DetcLab/piBatteryCycler/docs/adafruit_products_MCP4725_sch.png

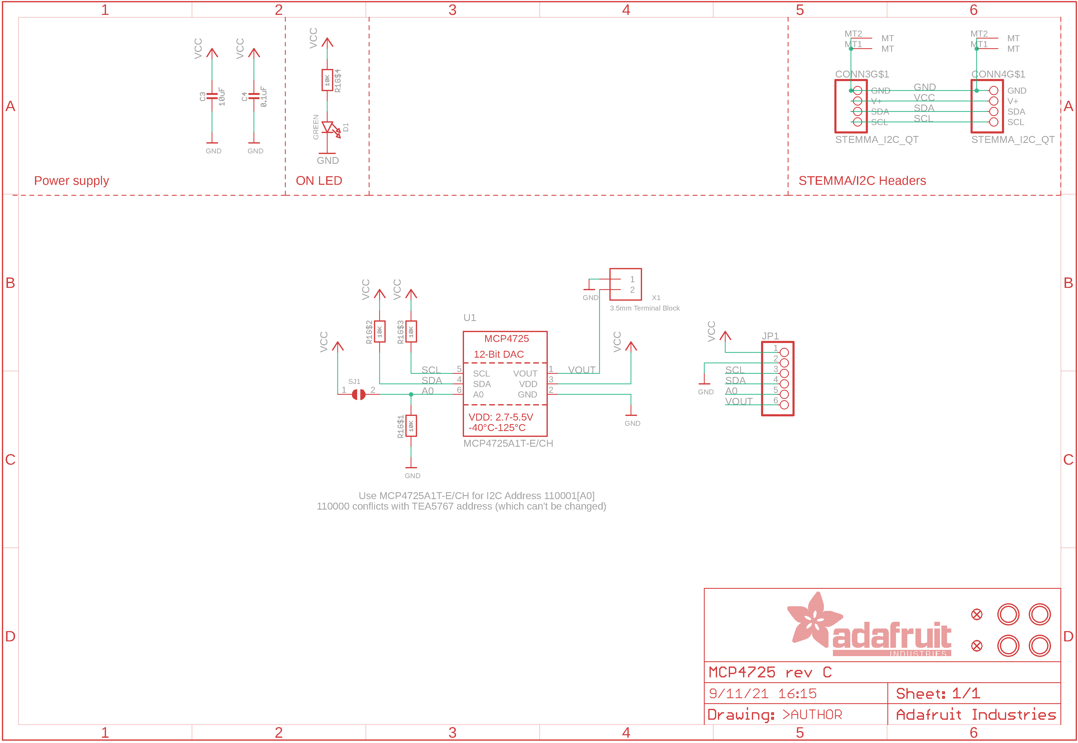
docs/adafruit_products_MCP4725_sch.png
