DetcLab/piBatteryCycler/docs/peligro-alta-temperatura-sin-rotulo.jpg

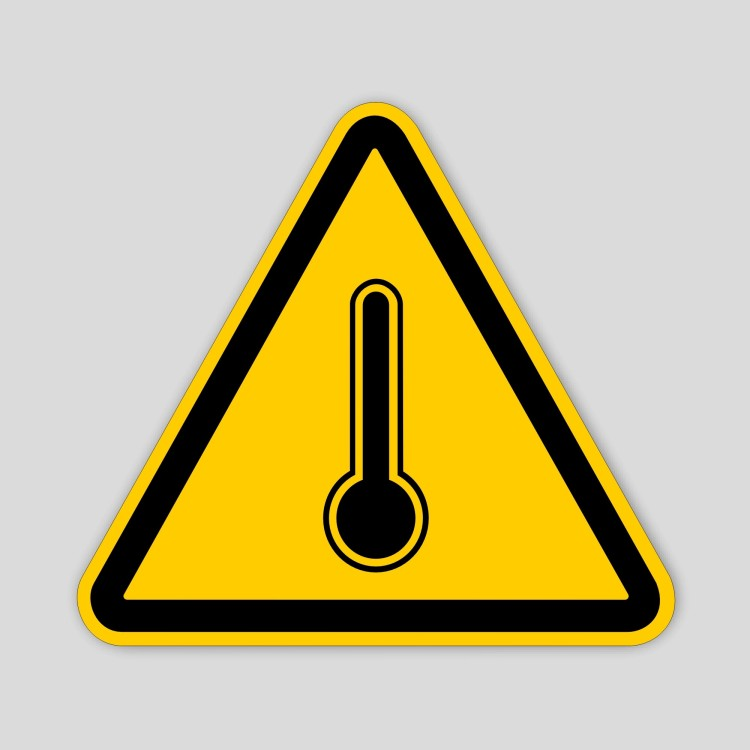
docs/peligro-alta-temperatura-sin-rotulo.jpg
