DetcLab/piBatteryCycler/pcb/V1_bq24_Soc_Externo/pi_battery_cycler.kicad_pcb

## KiCad design pcb/V1_bq24_Soc_Externo/pi_battery_cycler.kicad_pcb (2026-11-11)

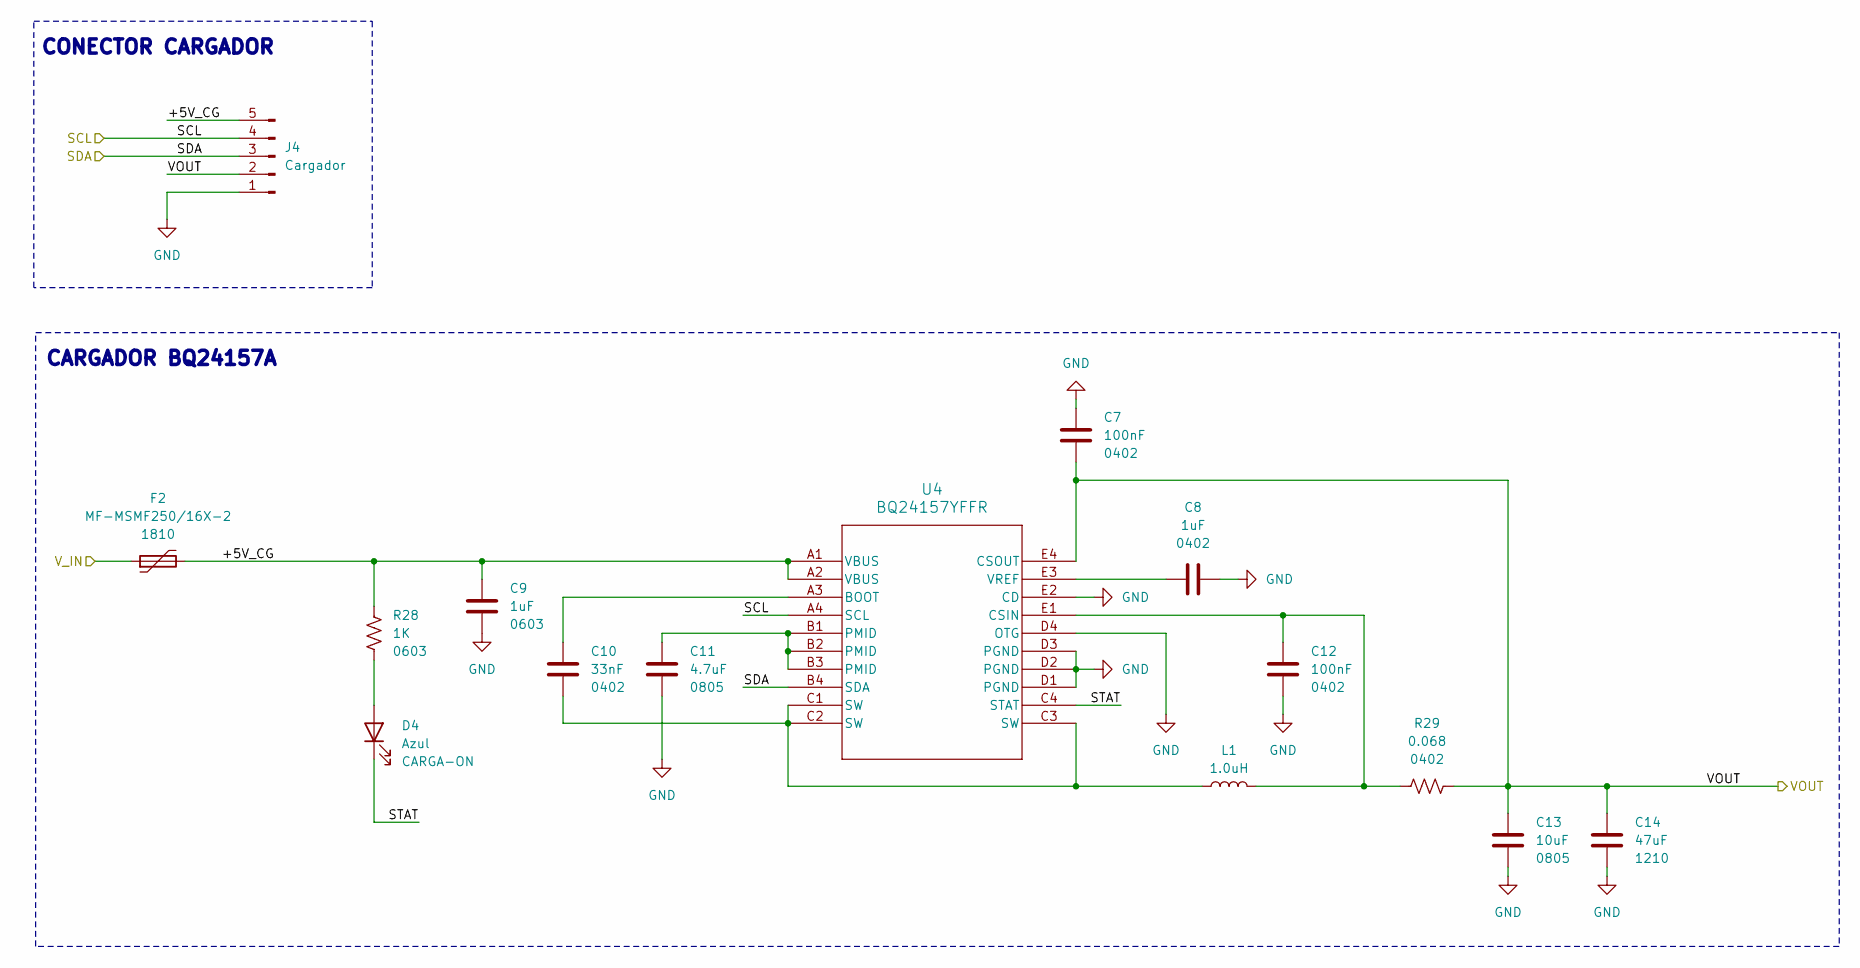
[picture p3: schematic cargador.kicad_sch, PI BATTERY CYCLER]

Parts:
C7, C12: 100nF; C_0402_1005Metric; MPN GRM155R71C104KA88D; Digikey 490-3261-2-ND
C8: 1uF; C_0402_1005Metric; MPN CL05A105KP5NNNC; Digikey 1276-1076-2-ND
C9: 1uF; C_0603_1608Metric_Pad1.08x0.95mm_HandSolder; MPN GRM188R61C105KA12D; Digikey 490-10479-2-ND
C10: 33nF; C_0402_1005Metric; MPN GRM155R61C333KA01D; Digikey 490-5416-2-ND
C11: 4.7uF; C_0805_2012Metric; MPN GRM21BR71C475KE51L; Digikey 490-14466-2-ND
C13: 10uF; C_0805_2012Metric; MPN CL21A106KOQNNNE; Digikey 1276-1096-2-ND
C14: 47uF; C_1210_3225Metric; MPN GRM32ER61A476KE20L; Digikey 490-3887-2-ND
D4: Azul; LED_0603_1608Metric; MPN 150060BS75000; Digikey 732-4966-2-ND
F2: MF-MSMF250/16X-2; Fuse_1812_4532Metric; MPN MF-MSMF250/16X-2; Digikey MF-MSMF250/16X-2TR-ND
J4: Cargador; JST_XH_B5B-XH-A_1x05_P2.50mm_Vertical
L1: 1.0uH; L_1008_2520Metric; MPN LQM2HPN1R0MJ0L; Digikey 490-6699-2-ND
R28: 1K; R_0603_1608Metric_Pad0.98x0.95mm_HandSolder; MPN RC0603FR-071KL; Digikey 311-1.00KHRTR-ND
R29: 0.068; R_0402_1005Metric; MPN ERJ-2BWJR068X; Digikey P.068AMTR-ND
U4: BQ24157YFFR; YFF20_TEX; MPN BQ24157YFFR; Digikey 296-39908-2-ND

Connections:
/CARGADOR/+5V_CG: C9.2, F2.2, J4.5, R28.1, U4.A1 (VBUS), U4.A2 (VBUS)
/CARGADOR/SCL: J4.4, U4.A4 (SCL); also elsewhere on the board
/CARGADOR/SDA: J4.3, U4.B4 (SDA); also elsewhere on the board
/CARGADOR/STAT: D4.1 (K), U4.C4 (STAT)
/CARGADOR/VOUT: C7.1, C13.2, C14.2, J4.2, R29.2, U4.E4 (CSOUT); also elsewhere on the board
/CARGADOR/V_IN: F2.1; also elsewhere on the board
GND: C7.2, C8.2, C9.1, C11.2, C12.1, C13.1, C14.1, J4.1, U4.D1 (PGND), U4.D2 (PGND), U4.D3 (PGND), U4.D4 (OTG), U4.E2 (CD); also elsewhere on the board
unnamed: C10.1, L1.1, U4.C1 (SW), U4.C2 (SW), U4.C3 (SW)
unnamed: C11.1, U4.B1 (PMID), U4.B2 (PMID), U4.B3 (PMID)
unnamed: D4.2 (A), R28.2
unnamed: C10.2, U4.A3 (BOOT)
unnamed: C12.2, L1.2, R29.1, U4.E1 (CSIN)
unnamed: C8.1, U4.E3 (VREF)

Notes on the sheet:
CONECTOR CARGADOR
CARGADOR BQ24157A

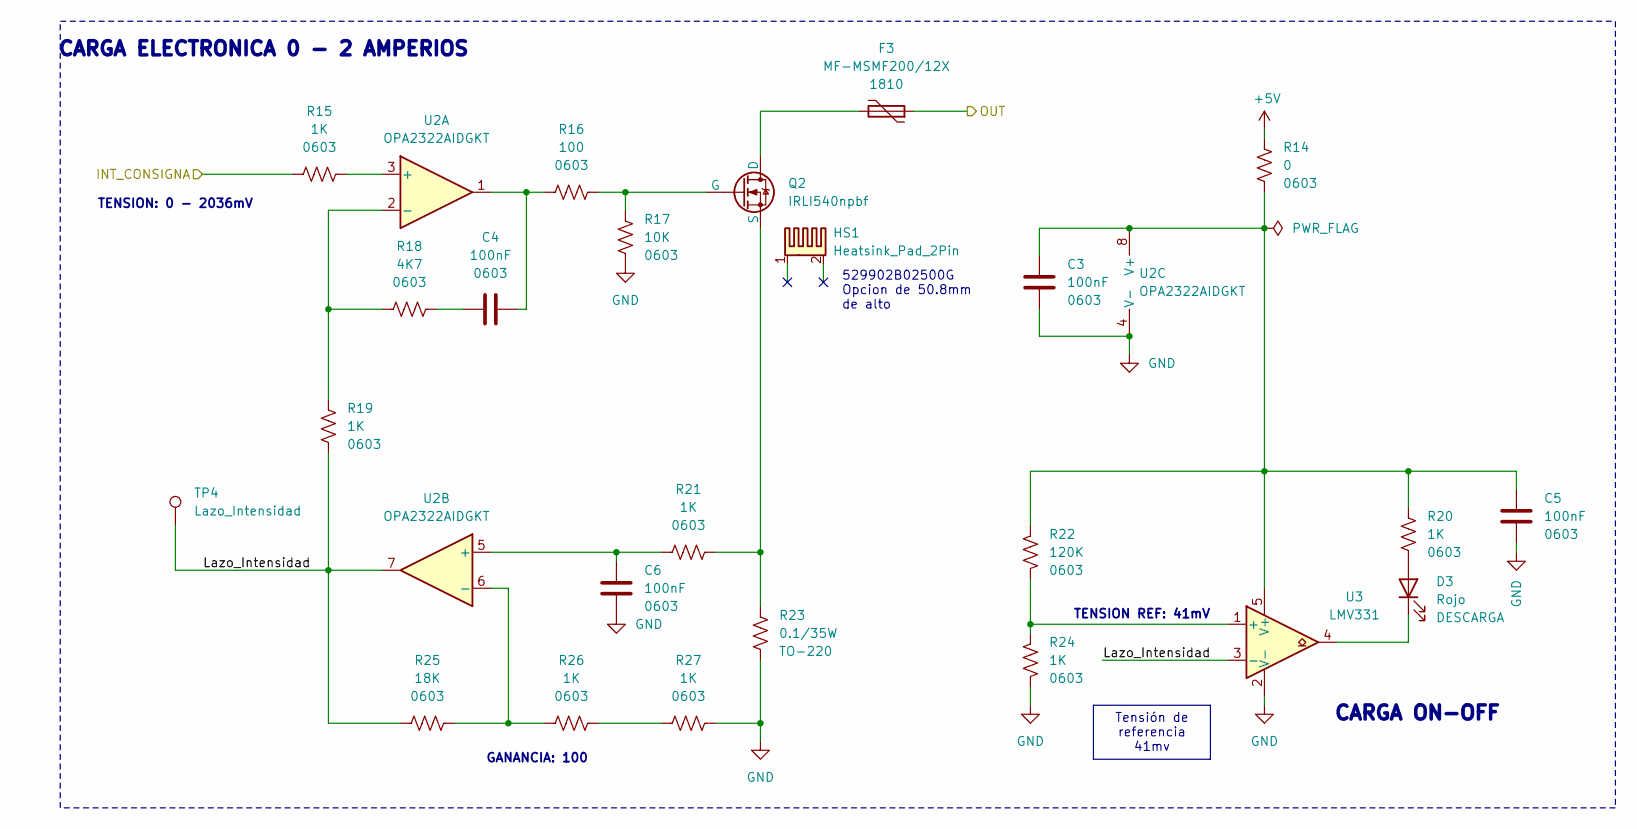
[picture p4: schematic carga.kicad_sch, PI BATTERY CYCLER]

Parts:
C3, C4, C5, C6: 100nF; C_0603_1608Metric_Pad1.08x0.95mm_HandSolder; MPN CL10B104KB8NNNC; Digikey 1276-1000-2-ND
D3: Rojo; LED_0603_1608Metric; MPN 150060RS75000; Digikey 732-4978-2-ND
F3: MF-MSMF200/12X; Fuse_1812_4532Metric; MPN MF-MSMF200/12X-2; Digikey 118-MF-MSMF200/12X-2TR-ND
HS1: Heatsink_Pad_2Pin; Heatsink_25.4x41.91mm_Aavid_529802B02500G; Digikey HS374-ND
Q2: IRLI540npbf; TO-220-3_Vertical; Digikey IRL540NPBF-ND
R14: 0; R_0603_1608Metric_Pad0.98x0.95mm_HandSolder; MPN RC0603FR-070RL; Digikey 311-0.0HRTR-ND
R15, R19, R20, R21, R24, R26, R27: 1K; R_0603_1608Metric_Pad0.98x0.95mm_HandSolder; MPN RC0603FR-071KL; Digikey 311-1.00KHRTR-ND
R16: 100; R_0603_1608Metric_Pad0.98x0.95mm_HandSolder; MPN RC0603FR-07100RL; Digikey 311-100HRTR-ND
R17: 10K; R_0603_1608Metric_Pad0.98x0.95mm_HandSolder; MPN RC0603FR-0710KL; Digikey 311-10.0KHRTR-ND
R18: 4K7; R_0603_1608Metric_Pad0.98x0.95mm_HandSolder; MPN RC0603FR-074K7L; Digikey 311-4.70KHRTR-ND
R22: 120K; R_0603_1608Metric_Pad0.98x0.95mm_HandSolder; MPN RC0603FR-07120KL; Digikey 311-120KHRTR-ND
R23: 0.1/35W; TO-220-2_Vertical; Digikey 696-1161-ND
R25: 18K; R_0603_1608Metric_Pad0.98x0.95mm_HandSolder; MPN RC0603FR-0718KL; Digikey 311-18.0KHRTR-ND
TP4: Lazo_Intensidad; TestPoint_Pad_D1.0mm
U2: OPA2322AIDGKT; VSSOP-8_3x3mm_P0.65mm; MPN OPA2322AIDGKT; Digikey 296-28774-2-ND
U3: LMV331; SOT-353_SC-70-5; MPN LMV331IDCKR; Digikey 296-6634-2-ND

Connections:
+5V: R14.1; also elsewhere on the board
/CARGA/INT_CONSIGNA: R15.2; also elsewhere on the board
/CARGA/Lazo_Intensidad: R19.2, R25.2, TP4.1 (1_1), U2.7, U3.3 (-)
/CARGADOR/VOUT: F3.1; also elsewhere on the board
GND: C3.2, C5.2, C6.2, R17.1, R23.2, R24.2, R27.1, U2.4 (V-), U3.2 (V-); also elsewhere on the board
unnamed: C4.1, R18.2
unnamed: C4.2, R16.1, U2.1
unnamed: D3.2 (A), R20.2
unnamed: D3.1 (K), U3.4
unnamed: F3.2, Q2.2 (D)
unnamed: Q2.1 (G), R16.2, R17.2
unnamed: Q2.3 (S), R21.1, R23.1
unnamed: R26.1, R27.2
unnamed: R15.1, U2.3 (+)
unnamed: R18.1, R19.1, U2.2 (-)
unnamed: C6.1, R21.2, U2.5 (+)
unnamed: R25.1, R26.2, U2.6 (-)
unnamed: C3.1, C5.1, R14.2, R20.1, R22.1, U2.8 (V+), U3.5 (V+)
unnamed: R22.2, R24.1, U3.1 (+)

Notes on the sheet:
529902B02500G Opcion de 50.8mm de alto
TENSION: 0 - 2036mV
CARGA ELECTRONICA 0 - 2 AMPERIOS
CARGA ON-OFF
TENSION REF: 41mV
GANANCIA: 100
Tensión de referencia 41mv

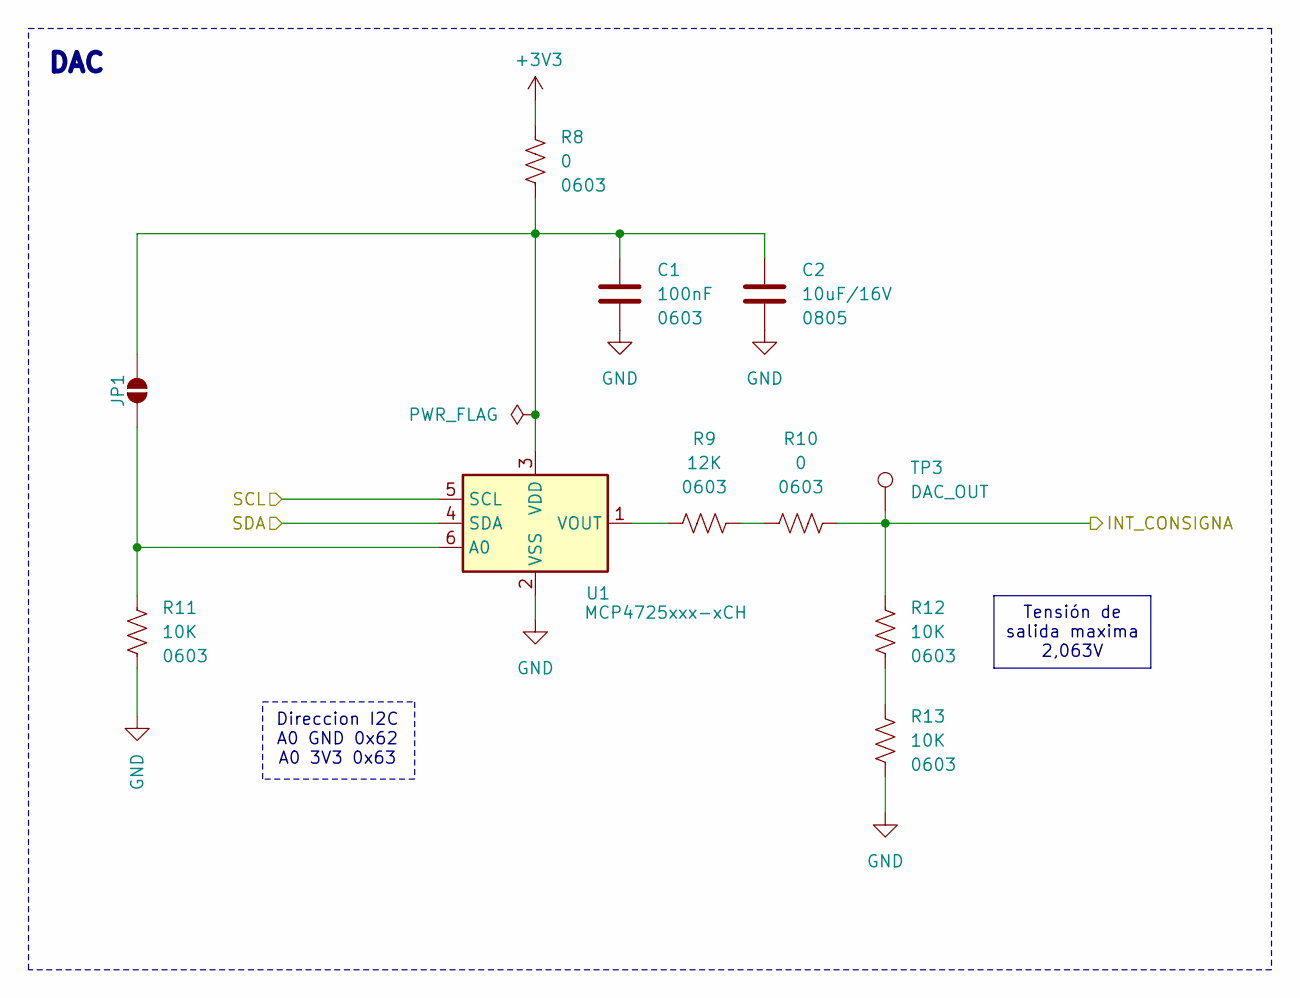
[picture p5: schematic dac.kicad_sch, PI BATTERY CYCLER]

Parts:
C1: 100nF; C_0603_1608Metric_Pad1.08x0.95mm_HandSolder; MPN CL10B104KB8NNNC; Digikey 1276-1000-2-ND
C2: 10uF/16V; C_0805_2012Metric; MPN CL21A106KOQNNNE; Digikey 1276-1096-2-ND
JP1: SolderJumper_2_Open; SolderJumper-2_P1.3mm_Open_RoundedPad1.0x1.5mm
R8, R10: 0; R_0603_1608Metric_Pad0.98x0.95mm_HandSolder; MPN RC0603FR-070RL; Digikey 311-0.0HRTR-ND
R9: 12K; R_0603_1608Metric_Pad0.98x0.95mm_HandSolder; MPN RC0603FR-0712KL; Digikey 311-12.0KHRTR-ND
R11, R12, R13: 10K; R_0603_1608Metric_Pad0.98x0.95mm_HandSolder; MPN RC0603FR-0710KL; Digikey 311-10.0KHRTR-ND
TP3: DAC_OUT; TestPoint_Pad_D1.0mm
U1: MCP4725xxx-xCH; SOT-23-6; MPN MCP4725A0T-E/CH; Digikey MCP4725A0T-E/CHCT-ND

Connections:
+3V3: R8.1; also elsewhere on the board
/CARGA/INT_CONSIGNA: R10.2, R12.2, TP3.1 (1_1); also elsewhere on the board
/CARGADOR/SCL: U1.5 (SCL); also elsewhere on the board
/CARGADOR/SDA: U1.4 (SDA); also elsewhere on the board
GND: C1.2, C2.2, R11.2, R13.1, U1.2 (VSS); also elsewhere on the board
unnamed: JP1.1 (A), R11.1, U1.6 (A0)
unnamed: C1.1, C2.1, JP1.2 (B), R8.2, U1.3 (VDD)
unnamed: R9.2, R10.1
unnamed: R12.1, R13.2
unnamed: R9.1, U1.1 (VOUT)

Notes on the sheet:
DAC
Direccion I2C A0 GND 0x62 A0 3V3 0x63
Tensión de salida maxima 2,063V

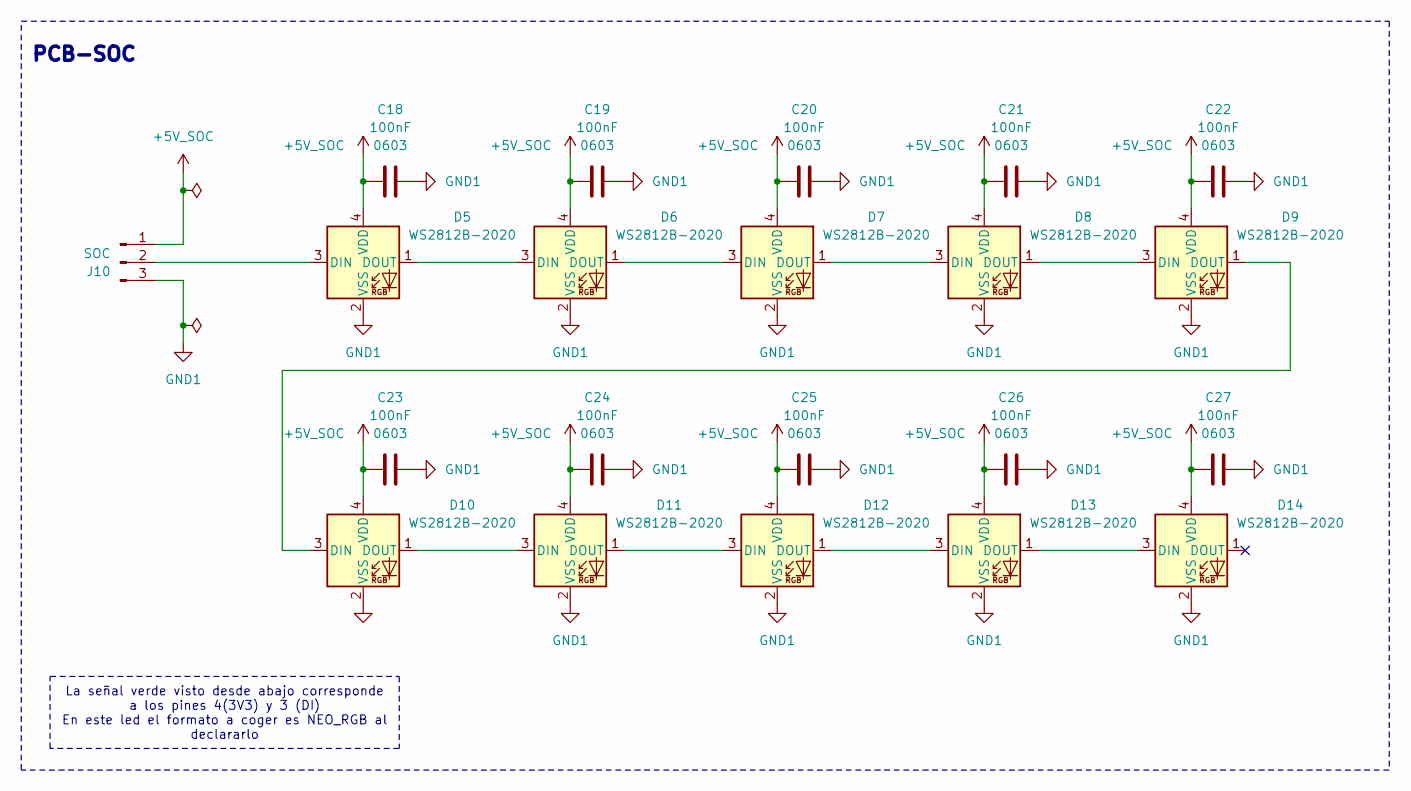
[picture p6: schematic pcb-soc.kicad_sch, PI BATTERY CYCLER]

Parts:
C18, C19, C20, C21, C22, C23, C24, C25, C26, C27: 100nF; C_0603_1608Metric_Pad1.08x0.95mm_HandSolder; MPN CL10B104KB8NNNC; Digikey 1276-1000-2-ND
D5, D6, D7, D8, D9, D10, D11, D12, D13, D14: WS2812B-2020; LED_WS2812B-2020_PLCC4_2.0x2.0mm; MPN 4684; Digikey 1528-4684-ND
J10: SOC; PinHeader_1x03_P2.54mm_Vertical

Connections:
+5V_SOC: C18.1, C19.1, C20.1, C21.1, C22.1, C23.1, C24.1, C25.1, C26.1, C27.1, D5.4 (VDD), D6.4 (VDD), D7.4 (VDD), D8.4 (VDD), D9.4 (VDD), D10.4 (VDD), D11.4 (VDD), D12.4 (VDD), D13.4 (VDD), D14.4 (VDD), J10.1
GND1: C18.2, C19.2, C20.2, C21.2, C22.2, C23.2, C24.2, C25.2, C26.2, C27.2, D5.2 (VSS), D6.2 (VSS), D7.2 (VSS), D8.2 (VSS), D9.2 (VSS), D10.2 (VSS), D11.2 (VSS), D12.2 (VSS), D13.2 (VSS), D14.2 (VSS), J10.3
unnamed: D5.3 (DIN), J10.2
unnamed: D5.1 (DOUT), D6.3 (DIN)
unnamed: D6.1 (DOUT), D7.3 (DIN)
unnamed: D7.1 (DOUT), D8.3 (DIN)
unnamed: D8.1 (DOUT), D9.3 (DIN)
unnamed: D9.1 (DOUT), D10.3 (DIN)
unnamed: D10.1 (DOUT), D11.3 (DIN)
unnamed: D11.1 (DOUT), D12.3 (DIN)
unnamed: D12.1 (DOUT), D13.3 (DIN)
unnamed: D13.1 (DOUT), D14.3 (DIN)

Notes on the sheet:
PCB-SOC
La señal verde visto desde abajo corresponde a los pines 4(3V3) y 3 (DI) En este led el formato a coger es NEO_RGB al declararlo

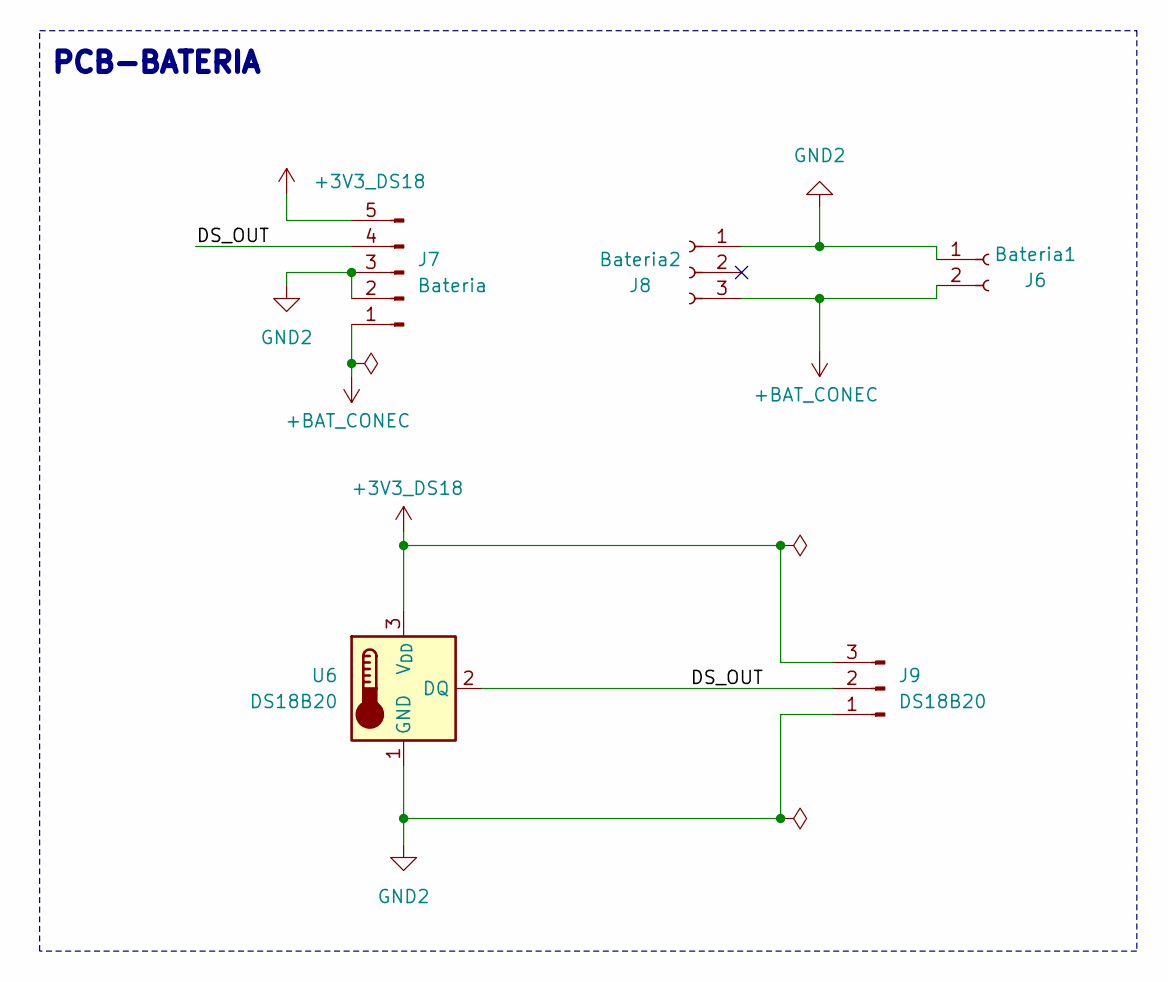
[picture p7: schematic pcb-bateria.kicad_sch, PI BATTERY CYCLER]

Parts:
J6: Bateria1; JST_XH_B2B-XH-A_1x02_P2.50mm_Vertical
J7: Bateria; PinHeader_1x05_P2.54mm_Vertical
J8: Bateria2; JST_XH_B3B-XH-A_1x03_P2.50mm_Vertical
J9: DS18B20; PinHeader_1x03_P2.54mm_Vertical
U6: DS18B20; TO-92_Inline; Digikey DS18B20+-ND

Connections:
+3V3_DS18: J7.5, J9.3, U6.3 (V_{DD})
+BAT_CONEC: J6.2, J7.1, J8.3
/PCB-BATERIA/DS_OUT: J7.4, J9.2, U6.2 (DQ)
GND2: J6.1, J7.2, J7.3, J8.1, J9.1, U6.1 (GND)

Notes on the sheet:
PCB-BATERIA

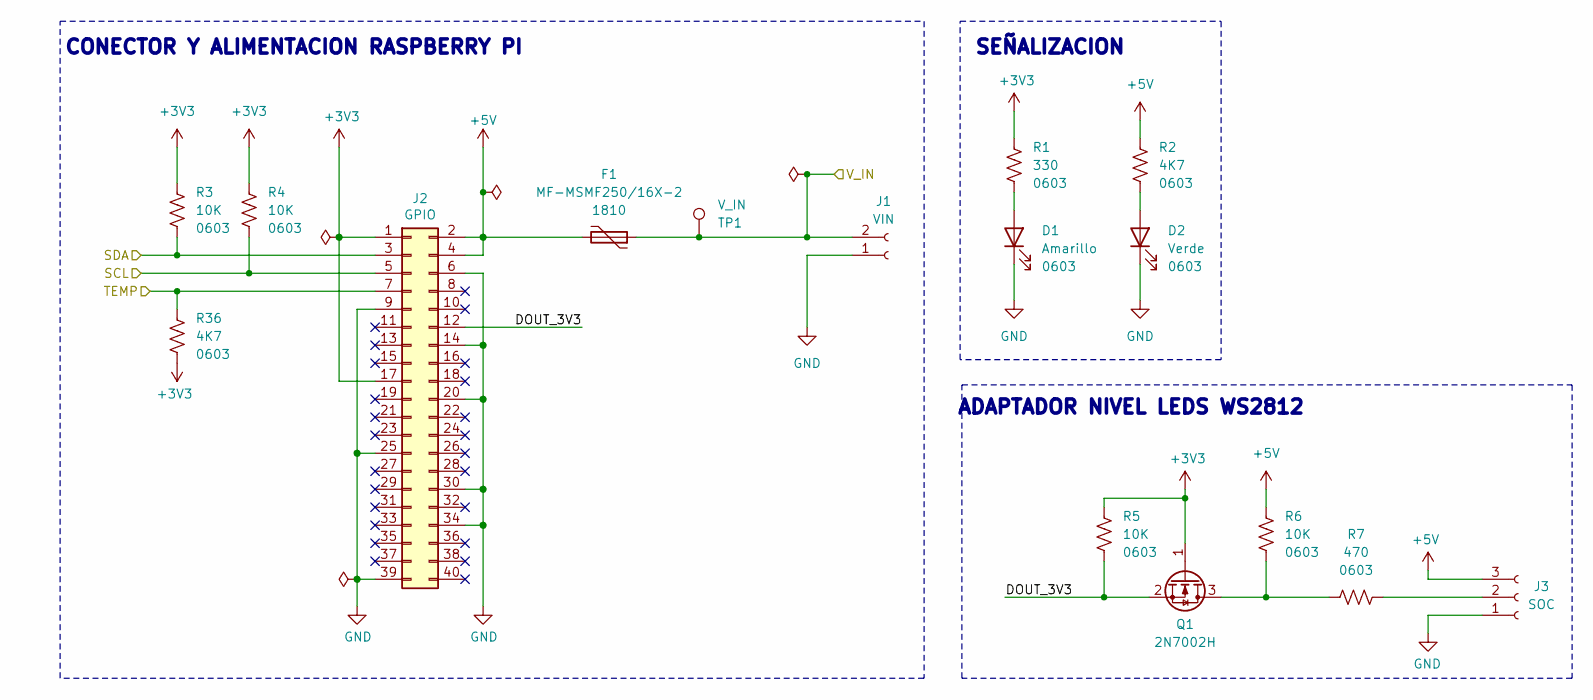
[picture p8: schematic raspberry.kicad_sch, PI BATTERY CYCLER]

Parts:
D1: Amarillo; LED_0603_1608Metric; MPN 150060YS75000; Digikey 732-4981-2-ND
D2: Verde; LED_0603_1608Metric; MPN 150060GS75000; Digikey 732-4971-2-ND
F1: MF-MSMF250/16X-2; Fuse_1812_4532Metric; MPN MF-MSMF250/16X-2; Digikey MF-MSMF250/16X-2TR-ND
J1: VIN; CUI_TB006-508-02BE; Digikey 102-6191-ND
J2: GPIO; PinSocket_2x20_P2.54mm_Vertical; Digikey 1528-1783-ND
J3: SOC; JST_XH_B3B-XH-A_1x03_P2.50mm_Vertical
Q1: 2N7002H; SOT-23; MPN 2N7002; Digikey 2N7002NTR-ND
R1: 330; R_0603_1608Metric_Pad0.98x0.95mm_HandSolder; MPN RC0603JR-071K5L; Digikey 311-1.5KGRTR-ND
R2, R36: 4K7; R_0603_1608Metric_Pad0.98x0.95mm_HandSolder; MPN RC0603FR-074K7L; Digikey 311-4.70KHRTR-ND
R3, R4, R5, R6: 10K; R_0603_1608Metric_Pad0.98x0.95mm_HandSolder; MPN RC0603FR-0710KL; Digikey 311-10.0KHRTR-ND
R7: 470; R_0603_1608Metric_Pad0.98x0.95mm_HandSolder; MPN RC0603FR-07470RL; Digikey 311-470HRTR-ND
TP1: V_IN; TestPoint_Pad_D1.0mm

Connections:
+3V3: J2.1, J2.17, Q1.1 (G), R1.1, R3.1, R4.1, R5.1, R36.2; also elsewhere on the board
+5V: F1.2, J2.2, J2.4, J3.3, R2.1, R6.1; also elsewhere on the board
/CARGADOR/SCL: J2.5, R4.2; also elsewhere on the board
/CARGADOR/SDA: J2.3, R3.2; also elsewhere on the board
/CARGADOR/V_IN: F1.1, J1.2, TP1.1 (1_1); also elsewhere on the board
/MEDIDOR/TEMP: J2.7, R36.1; also elsewhere on the board
/RASPBERRY/DOUT_3V3: J2.12, Q1.2 (S), R5.2
GND: D1.1 (K), D2.1 (K), J1.1, J2.6, J2.9, J2.14, J2.20, J2.25, J2.30, J2.34, J2.39, J3.1; also elsewhere on the board
unnamed: D1.2 (A), R1.2
unnamed: D2.2 (A), R2.2
unnamed: J3.2, R7.2
unnamed: Q1.3 (D), R6.2, R7.1

Notes on the sheet:
CONECTOR Y ALIMENTACION RASPBERRY PI
ADAPTADOR NIVEL LEDS WS2812
SEÑALIZACION

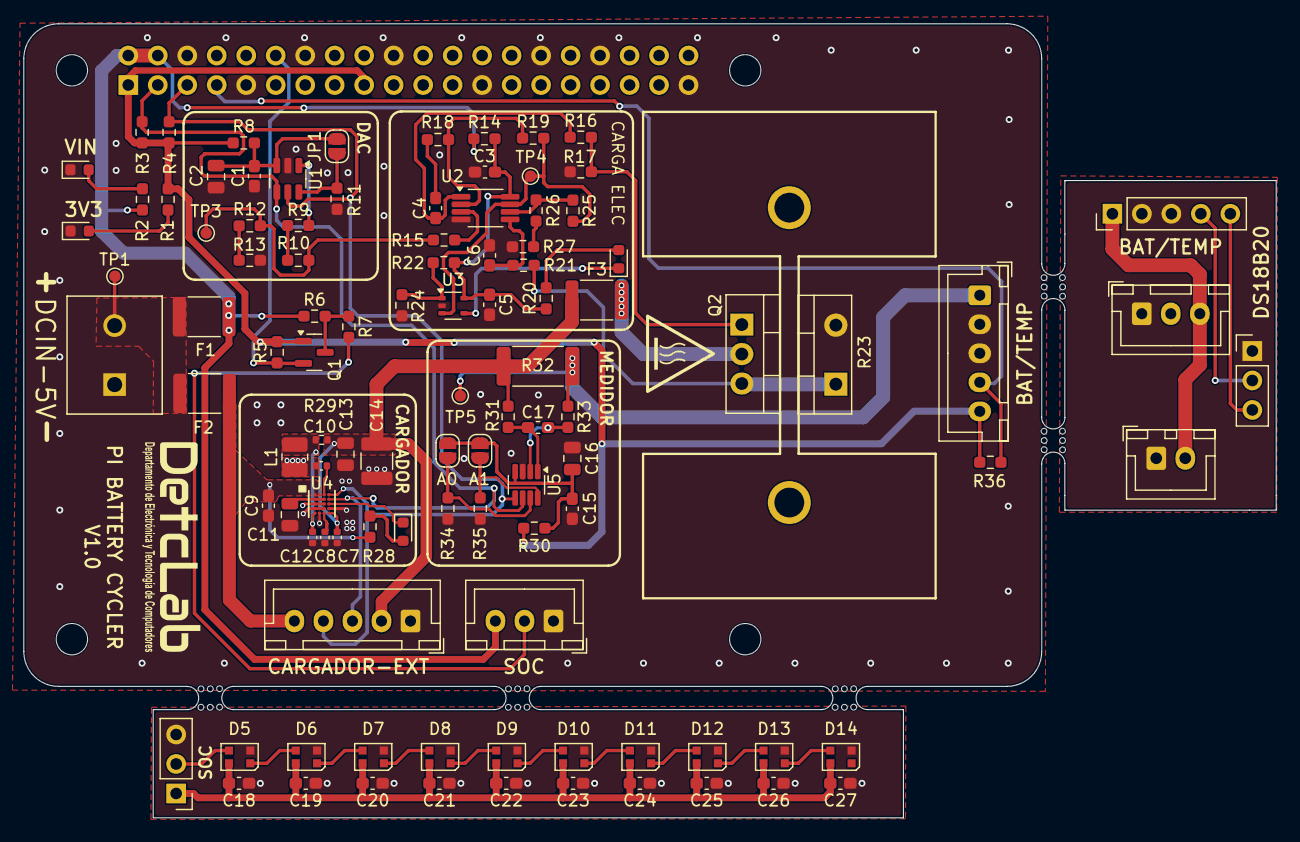
[picture p9: board pi_battery_cycler.kicad_pcb from above]

Board: 2 copper layers, 107.9 x 68.4 mm, 115 parts (1 on the bottom side), 64 nets.

Other parts of the board:
C15, C17: 100nF; C_0603_1608Metric_Pad1.08x0.95mm_HandSolder
C16: 10uF/16V; C_0805_2012Metric
J5: Bateria; JST_XH_B5B-XH-A_1x05_P2.50mm_Vertical
JP2, JP3: SolderJumper_2_Open; SolderJumper-2_P1.3mm_Open_RoundedPad1.0x1.5mm
MH1, MH2, MH3, MH4: MountingHole_2.7mm_M2.5
R30, R31, R33: 0; R_0603_1608Metric_Pad0.98x0.95mm_HandSolder
R32: 0.1 / 1W; R_2512_6332Metric
R34, R35: 10K; R_0603_1608Metric_Pad0.98x0.95mm_HandSolder
TP5: +BAT; TestPoint_Pad_D1.0mm
U5: INA219AxDCN; SOT-23-8
mouse-bite-2mm-4mm, mouse-bite-2mm-4mm#2, mouse-bite-2mm-4mm#3, mouse-bite-2mm-4mm#4, mouse-bite-2mm-4mm#5: VAL**; mouse-bite-2mm-4mm

Their connections:
+3V3: J5.5, R30.1; also elsewhere on the board
/CARGADOR/SCL: U5.5 (SCL); also elsewhere on the board
/CARGADOR/SDA: U5.6 (SDA); also elsewhere on the board
/CARGADOR/VOUT: R31.1, R32.1; also elsewhere on the board
/MEDIDOR/TEMP: J5.4; also elsewhere on the board
GND: C15.2, C16.2, J5.2, J5.3, R34.2, R35.2, U5.3 (GND); also elsewhere on the board
unnamed: J5.1, R32.2, R33.1, TP5.1 (1_1)
unnamed: JP2.1 (A), R34.1, U5.7 (A0)
unnamed: C15.1, C16.1, JP2.2 (B), JP3.2 (B), R30.2, U5.4 (VS)
unnamed: JP3.1 (A), R35.1, U5.8 (A1)
unnamed: C17.2, R31.2, U5.1 (IN+)
unnamed: C17.1, R33.2, U5.2 (IN-)
